Hannah-Kaliada/Rattysitter/README.md

# Дипломный проект 🐭 

dancing rat  

# TODO
- технология vox
## Содержание

- [Аппаратная часть](./hardware/)  
- [Программная часть](./software/)  
- [Документация](./docs/)  
- [Даташиты](./datasheets/)
- [Ссылки](./links/links.md)
- [График](https://docs.google.com/spreadsheets/d/1RWUDlwNgSnQZzl1ud5IH15s1hvJBND-iSX5JjFd0lDk/edit?gid=0#gid=0)  

## 🐀 Мои бусечки 

- Сара — **שרה**  

- Хава — **חוה**  
- Милка — **מלכה**  
- Соня — **סוניה**  
- Ада — **עדה**
