Hannah-Kaliada/Rattysitter/literature/links.txt

https://www.espressif.com/en/solutions/low-power-solutions/esp-now
https://randomnerdtutorials.com/esp-now-esp32-arduino-ide/
