Hannah-Kaliada/Rattysitter/links/links.md

## 🔗 Список

- [ESP32-CAM AI-Thinker Pinout Guide (Random Nerd Tutorials)](https://randomnerdtutorials.com/esp32-cam-ai-thinker-pinout/)
