Hannah-Kaliada/Rattysitter/docs/Ведомость_2025.pdf

Изм. Лист | | № докум. | Подп. | Дата
Разраб. | Коледа | | | Устройство мониторинга комнаты ребенка. Ведомость документов | Лит. | Лист | Листов
Пров. | Стракович | | | | | Т | | 66 | 66
Т. контр. | | | | | ЭВМ, гр. 250503
Н. контр.
Утв.

## БГУИР КП 1–40 02 01 312 Д1

Обозначение | Наименование | Примечание
| Графические документы
ГУИР.400201.312 ПД ГУИР.400201.312 ПД | Устройство мониторинга комнаты ребенка. Устройство мониторинга комнаты ребенка.
| Схема программы Схема программы | Формат А3
ГУИР.400201.312 Э1 | Устройство мониторинга комнаты ребенка.
| Схема электрическая структурная | Формат А4
ГУИР.400201.312 Э2 ГУИР.400201.312 Э2 | Устройство мониторинга комнаты ребенка. Устройство мониторинга комнаты ребенка.
| Схема электрическая функциональная Схема электрическая функциональная | Формат А3 Формат А3
ГУИР.400201.312 Э3 ГУИР.400201.312 Э3 | Устройство мониторинга комнаты ребенка. Устройство мониторинга комнаты ребенка.
| Схема электрическая принципиальная Схема электрическая принципиальная | Формат А3 Формат А3
ГУИР.400201.312 МЭ ГУИР.400201.312 МЭ | Устройство мониторинга комнаты ребенка. Устройство мониторинга комнаты ребенка.
| Схема платы Схема платы | Формат А4 Формат А4
ГУИР.400201.312 ВО ГУИР.400201.312 ВО | Устройство мониторинга комнаты ребенка. Устройство мониторинга комнаты ребенка.
| Схема модели корпуса Схема модели корпуса | Формат А4 Формат А4
| Текстовые документы
БГУИР КП БГУИР КП 1–40 02 01 312 40 02 01 312 ПЗ | Пояснительная записка Пояснительная записка | 66 с.
ГУИР.400201.312 ПЭ3 | Устройство мониторинга комнаты ребенка.
| Перечень элементов | 1 л., в ПЗ

Изм. Лист | № докум. | Подп. | Дата

## БГУИР КП 1–40 02 01 YYY Д1

Лист
2
Обозначение | Наименование | Примечание
