Hannah-Kaliada/Rattysitter/docs/модель корпуса.pdf

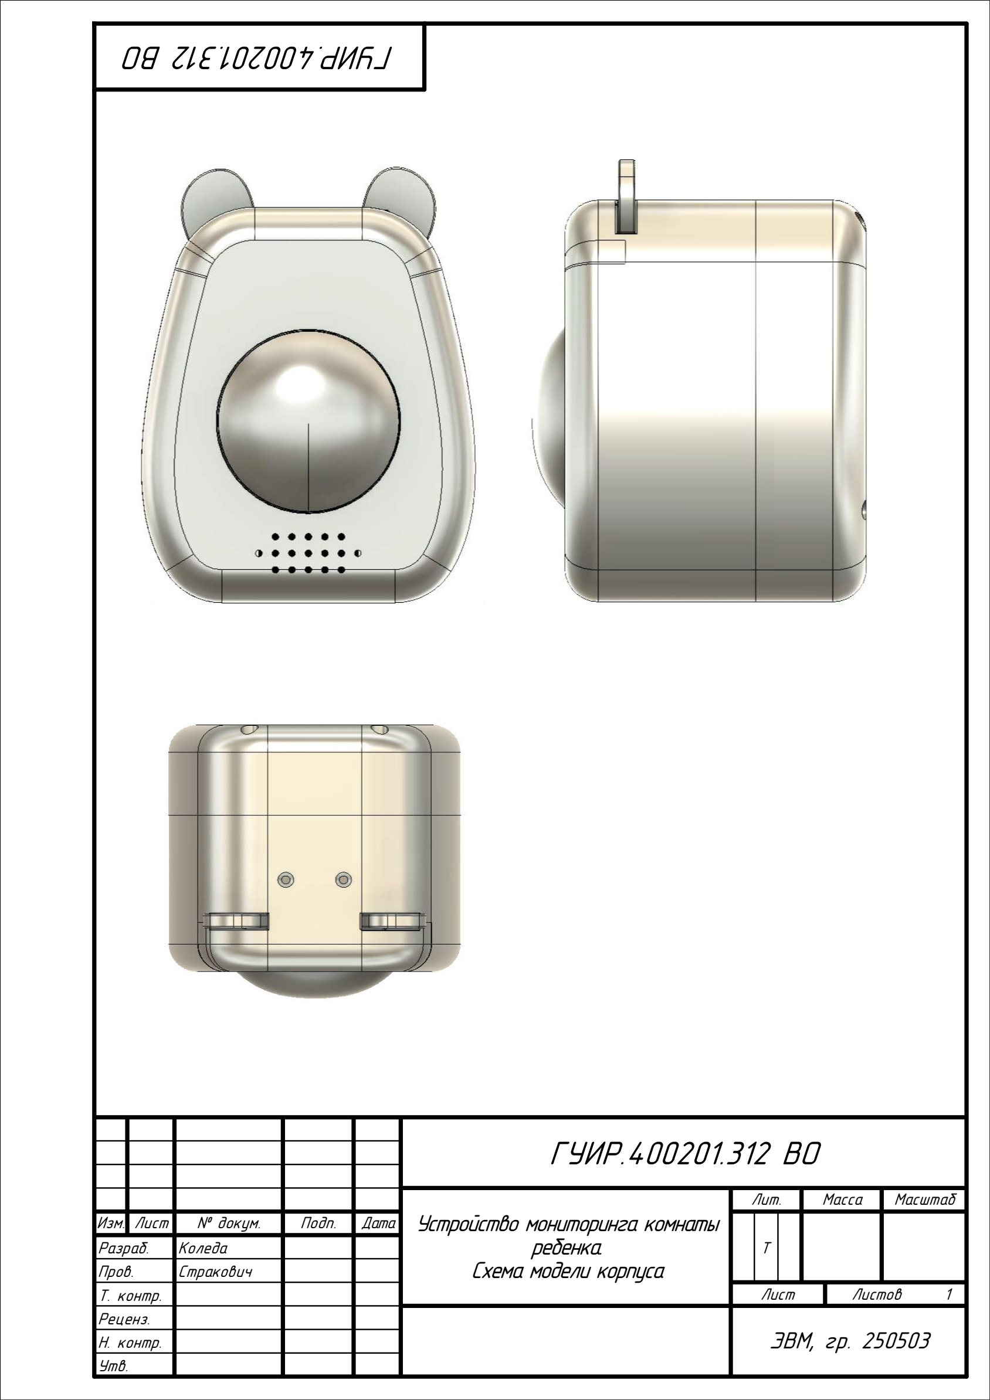
[picture p1: page 1]

| | | | ГУИР.400201.312 ВО
| | | | Устройство мониторинга комнаты ребенка. Схема модели корпуса | Лит. | Масса | Масштаб
Изм. Лист | № докум. | Подп. | Дата | | | Т
Разраб. | Коледа
Пров. | Стракович
Т. контр. | | | | Лист | Листов
Реценз. | | | | ЭВМ, гр. 250503
Н. контр.
Утв.

Изм. Лист | | № докум. | Подп. | Дата
Разраб. | Фамилия | | | Название. Тип чертежа | Лит. | Лист | Листов
Пров. | Фамилия | | | | | Т | | 2
Т. контр. | | | | | ЭВМ, гр. XXXXXX
Н. контр.
Утв.

# ГУИР.400201.YYY ZZ

Изм. Лист | № докум. | Подп. | Дата

# ГУИР.400201.YYY ZZ

Лист
