Hannah-Kaliada/Rattysitter/docs/перечень 2025.pdf

Изм. Лист | | № докум. | Подп. | Дата
Разраб. | Коледа | | | Устройство мониторинга комнаты ребенка. Перечень элементов | Лит. | Лист | Листов
Пров. | Стракович | | | | | Т | | 1 | 1
Т. контр. | | | | | ЭВМ, гр. 250503
Н. контр.
Утв.

## ГУИР.400201.312 ПЭ3

Поз. обозна-чение | Наименование | Кол. | Примечание
| Микросхемы
DD1 | AHT10 / DIP-4, датчик температуры, влажности , датчик температуры, влажности | 1
DD2 | ESP32-WROOM-32 / DIP-34, микроконтроллер | 1
DD3 | INMP-441 / DIP-6, микрофон | 1
DD4 | HW-084 / DIP-10, часы реального времени | 1
DD5 | BH1750/ DIP-5, датчик уровня освещенности | 1

Зона

HG1 HG1 | OLED-0.96-4IIC-Y, OLED-дисплей 128x64 OLED-0.96-4IIC-Y, OLED-дисплей 128x64
| пикселей пикселей | 1 1
HL1..HL5 GNL-8003RGB-C-TL, Светодиод многоцветный 25° HL1..HL5 GNL-8003RGB-C-TL, Светодиод многоцветный 25°
| d=8мм 30мА, с общим катодом d=8мм 30мА, с общим катодом | 5 5
| Резисторы
R1..R15 | CF1/4W-470R резистор выводной, 470 Ом
| 0.25 Вт, ±5% | 15
| Разъемы
XS1 | TYPE-C-2Pin-M, гнездо, 2 контакта, прямой | 1

Изм. Лист | № докум. | Подп. | Дата

## ГУИР.400201.YYY ПЭ3

Поз. обозна-чение | Наименование | Кол. | Примечание
| Резисторы
R1, R2 R1, R2 | С2-29В-0,5Вт резистор выводной, 10 кОм С2-29В-0,5Вт резистор выводной, 10 кОм
| 0.5 Вт, ±0.25% 0.5 Вт, ±0.25% | 2 2
R3 | Резистор выводной 240 Ом, 0.5 Вт, ±5% | 1
R4...R9 R4...R9 | RC1206FR-074K7L резистор SMD 1206 RC1206FR-074K7L резистор SMD 1206
| 4.7 кОм, 0.25 Вт, ±1% 4.7 кОм, 0.25 Вт, ±1% | 6 6

Зона

Лист
2
| Диоды

VD1...VD4 1N4005, диод выпрямительный, 1 А, 600 В, VD1...VD4 1N4005, диод выпрямительный, 1 А, 600 В,

| DO-41 DO-41 | 4 4
VD5, VD6 VD5, VD6 1N5818, 1N5818, диод Шоттки, 30 В, 1 А, диод Шоттки, 30 В, 1 А, DO-41 | | 2
| Разъемы

XP1, XP2 PLS-4 (DS-1021-1x4), вилка штыревая XP1, XP2 PLS-4 (DS-1021-1x4), вилка штыревая

| шаг 2.54мм, 4 контакта, прямая шаг 2.54мм, 4 контакта, прямая | 2 2
| Устройства коммутации
SA1 | EG1213, EG1213, переключатель движковый, переключатель движковый, ВКЛ-ВКЛ | 1
SA2 | MTS-102 A-2, тумблер ВКЛ тумблер ВКЛ-ВКЛ | 1
SW1...SW3 KAN1211 KAN1211-1201B, кнопка тактовая кнопка тактовая 12x12x12 mm 12x12x12 mm | | 3
| Транзисторы
VT1 | IRF520NPBF, IRF520NPBF, N-канал, 100 В, 9.7 А канал, 100 В, 9.7 А | 1
