Hannah-Kaliada/Rattysitter/docs/схема платы.pdf

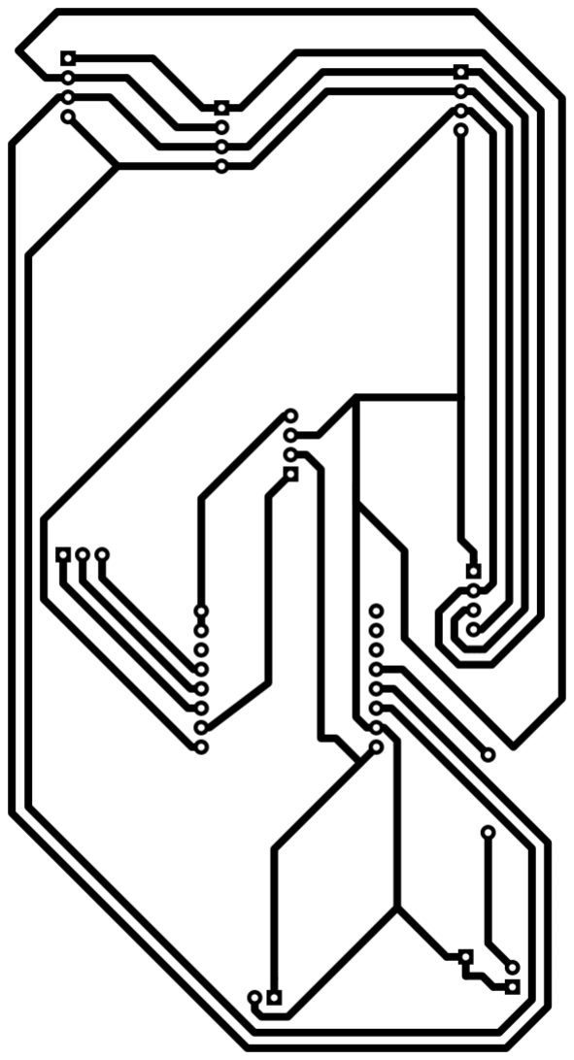
[picture p9: figure]

| | | | | ГУИР.400201.311 МЭ1
| | | | | Схема платы. Схема электромонтажная | Лит. | Масса | Масштаб
Изм.Лист | | № докум. | Подп. | Дата | | | У
Разраб. | | Коледа
Пров. | | Селезнев
Лист | Листов 1
| | | | | ЭВМ, гр. 250503
