Hannah-Kaliada/Rattysitter/docs/PCB_PCB_bear_2025-05-05-2.png

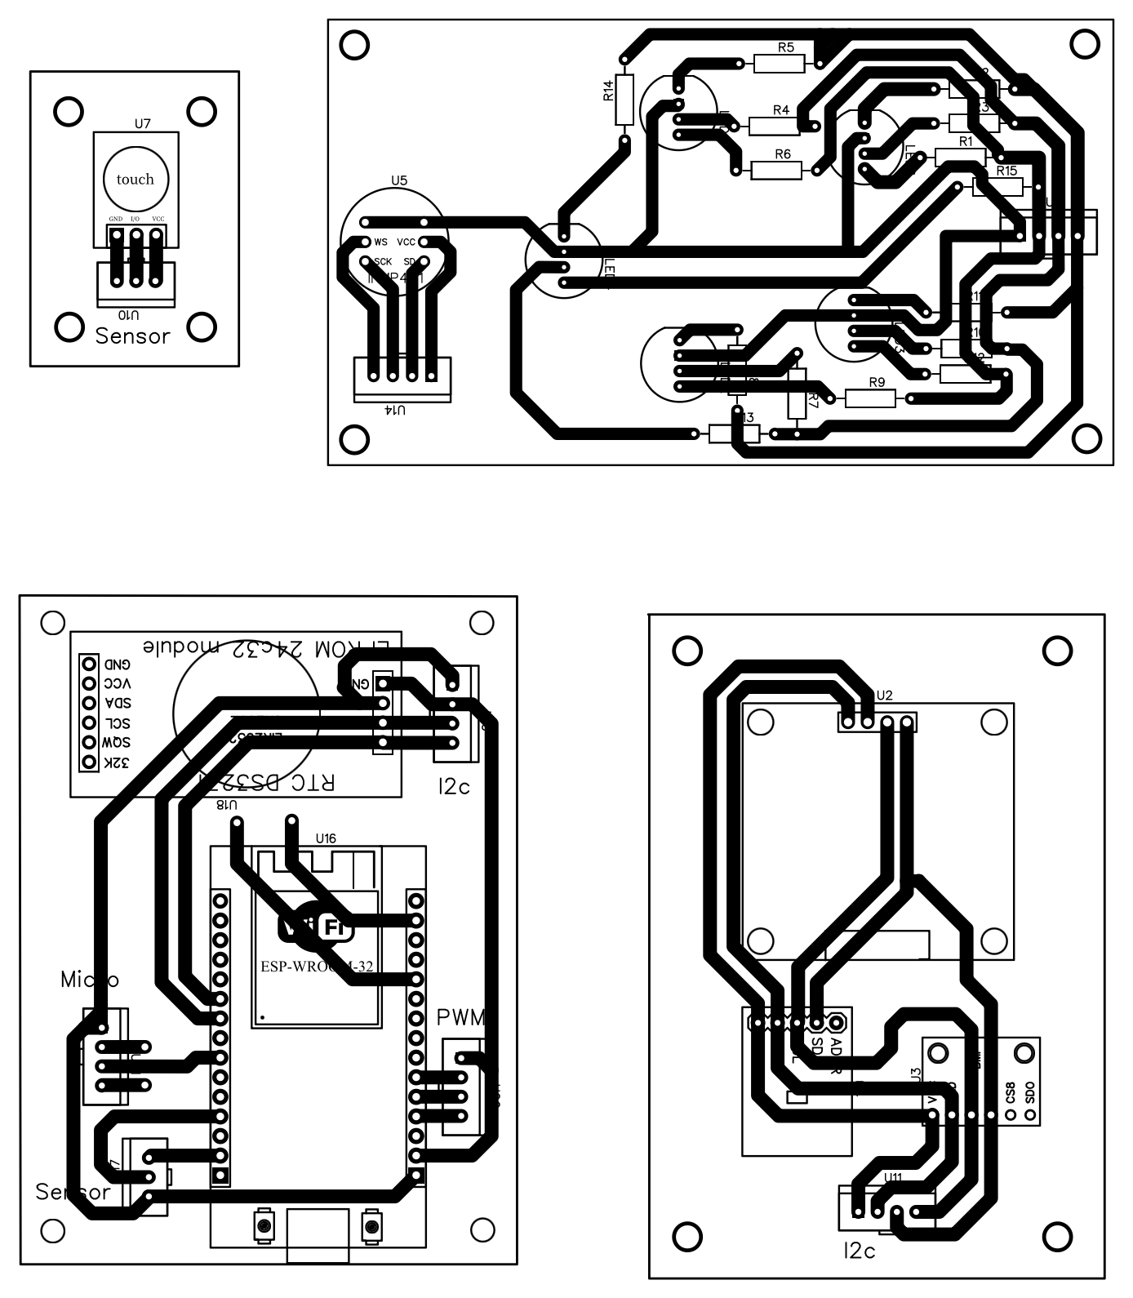
docs/PCB_PCB_bear_2025-05-05-2.png
