Hannah-Kaliada/Rattysitter/docs/Принципиальная схема.pdf

A

B

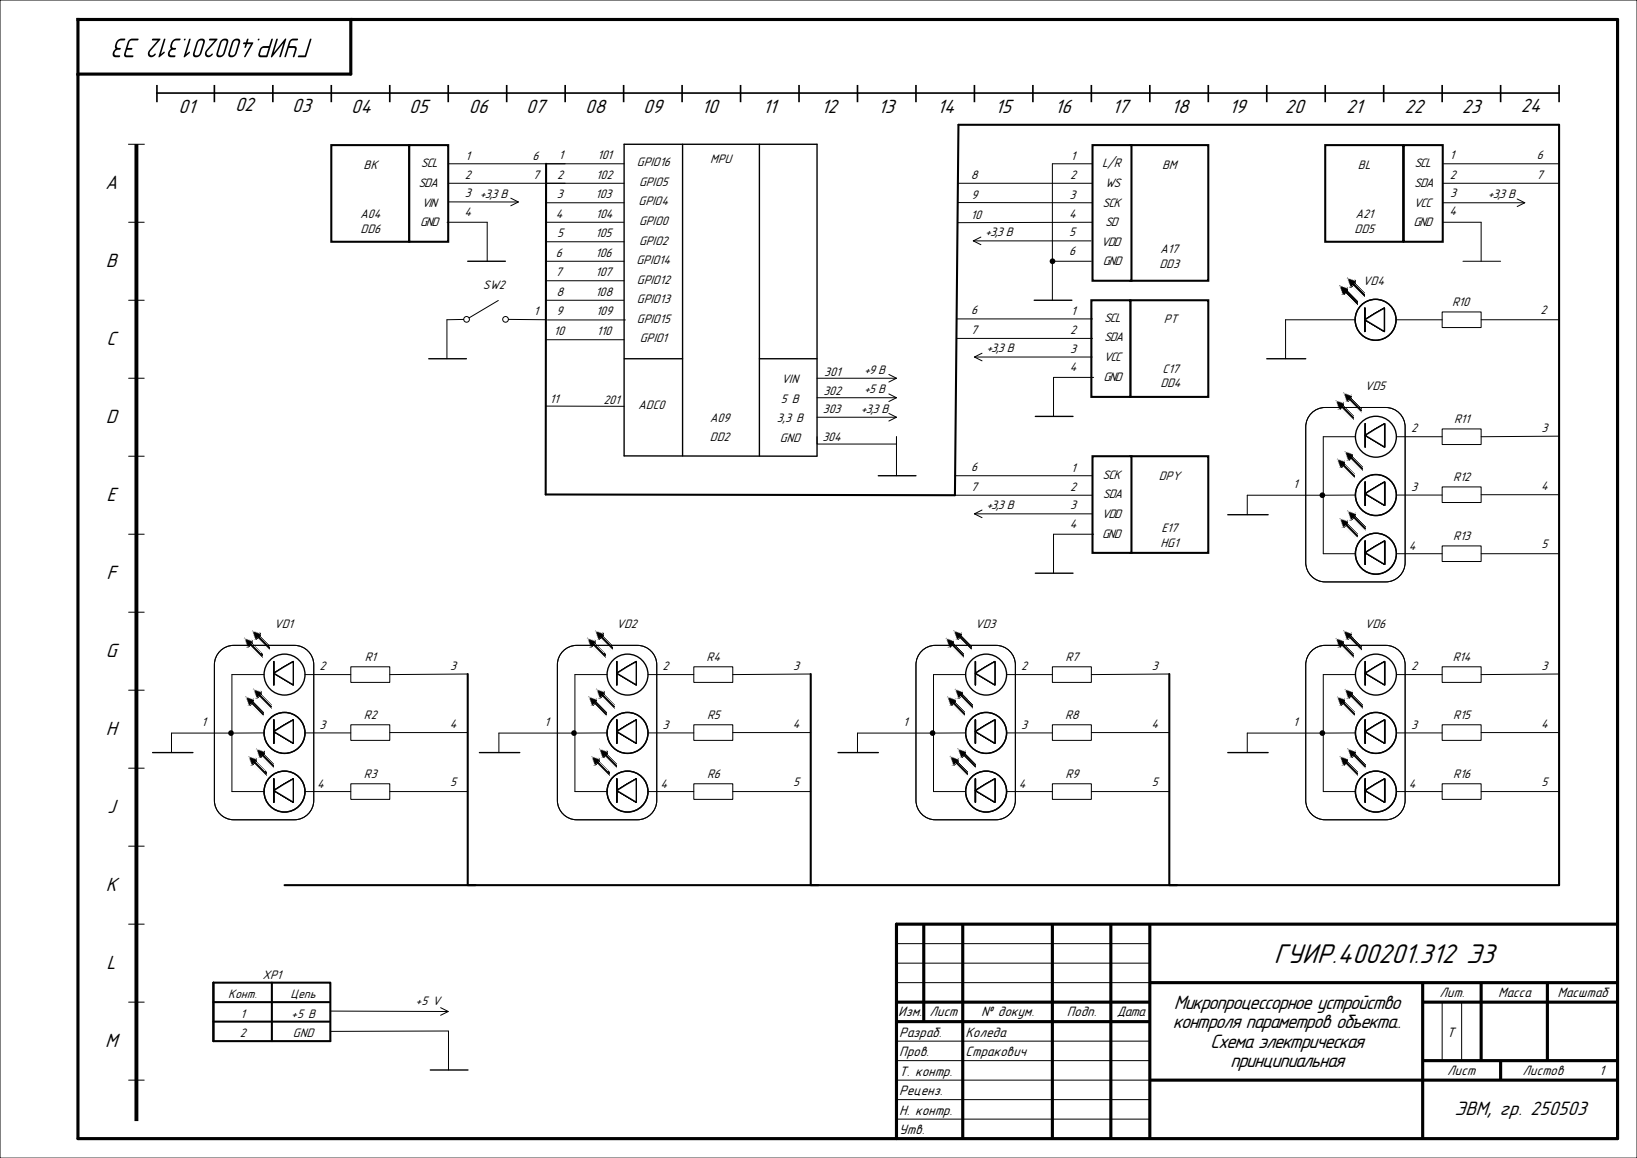
[picture p11: page 1]

GPIO16 GPIO5 GPIO4 GPIO0 GPIO2 GPIO14 GPIO12 GPIO13 GPIO15 GPIO1 | MPU A09 DD2

ADC0 | | VIN 5 В 3,3 В GND | 4

ГУИР.400201.312 Э3

Микропроцессорное устройство контроля параметров объекта.. Схема электрическая принципиальная | Лит. | Масса | Масштаб

Пров. | Стракович
Т. контр. | | Лист | Листов 1
Реценз. | | ЭВМ, гр. 250503
Н. контр.
Утв.
