Hannah-Kaliada/Rattysitter/docs/функциональная 2025.pdf

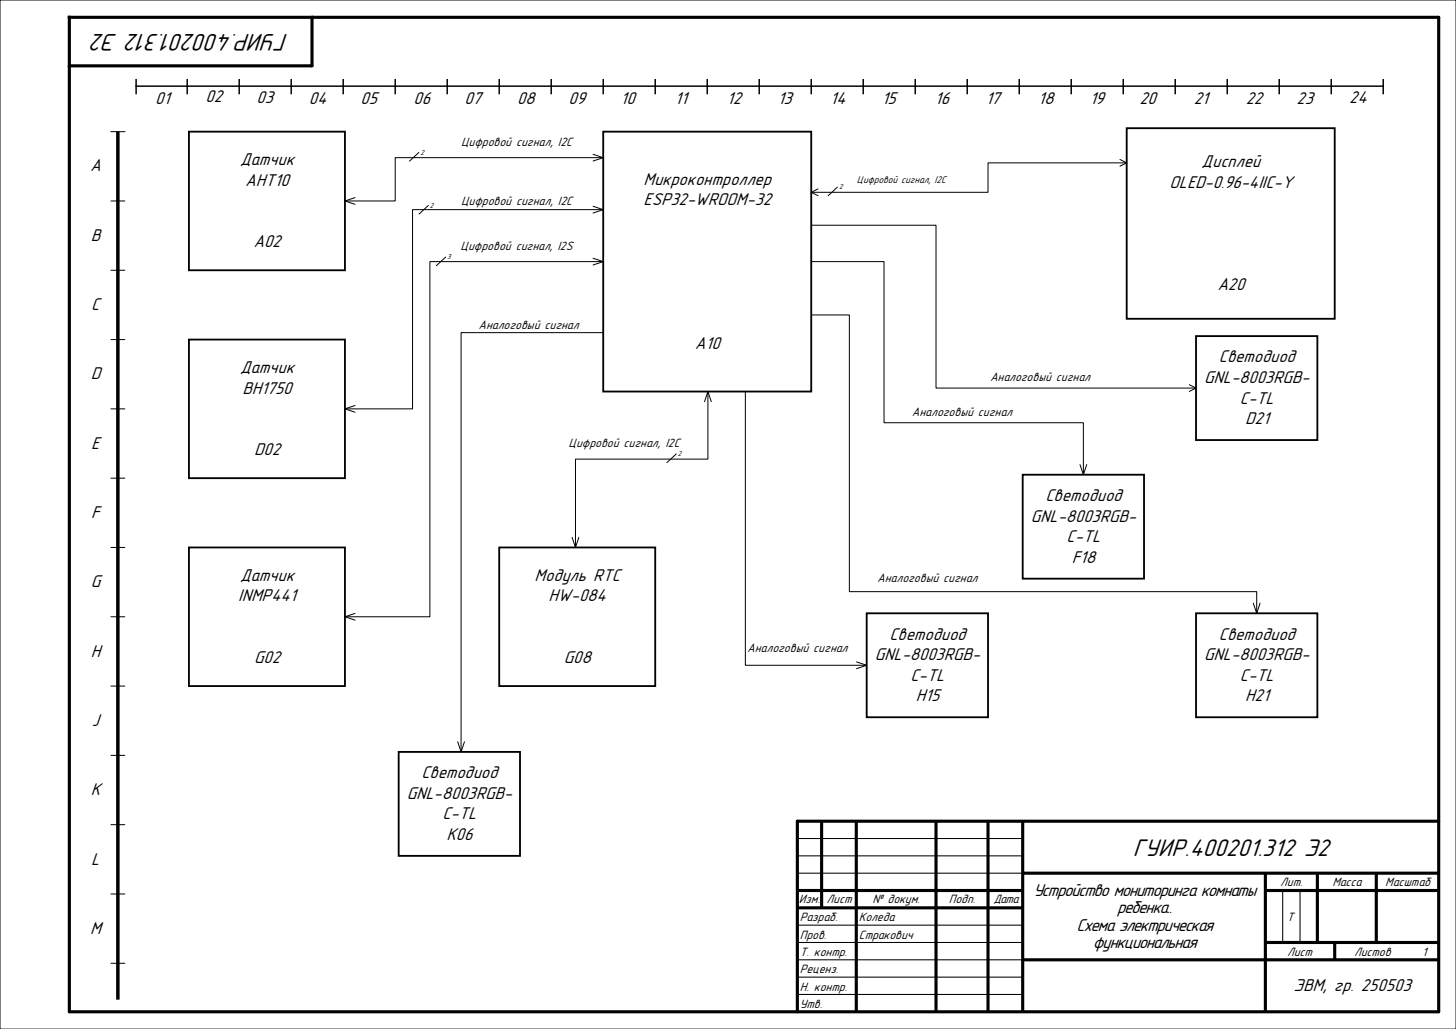
[picture p12: page 1]
Микроконтроллер ESP32-WROOM-32; Дисплей OLED-0.96-4IIC-Y; Светодиод GNL-8003RGB- C-TL D21; Датчик AHT10; Датчик BH1750; Датчик INMP441; Цифровой сигнал, I2C; Аналоговый сигнал; Цифровой сигнал, I2S; Модуль RTC HW-084; Светодиод GNL-8003RGB- C-TL F18; Светодиод GNL-8003RGB- C-TL H21; Светодиод GNL-8003RGB- C-TL H15; Светодиод GNL-8003RGB- C-TL K06

ГУИР.400201.312 Э2

Устройство мониторинга комнаты ребенка.. Схема электрическая функциональная | Лит. | Масса | Масштаб

Изм. Лист | № докум. | Подп. | Дата | | | Т
Разраб. | Коледа
Пров. | Стракович
Т. контр. | | | | Лист | Листов 1
Реценз. | | | | ЭВМ, гр. 250503
Н. контр.
Утв.
