Hannah-Kaliada/Rattysitter/docs/принципиальная 2025.pdf

A

B

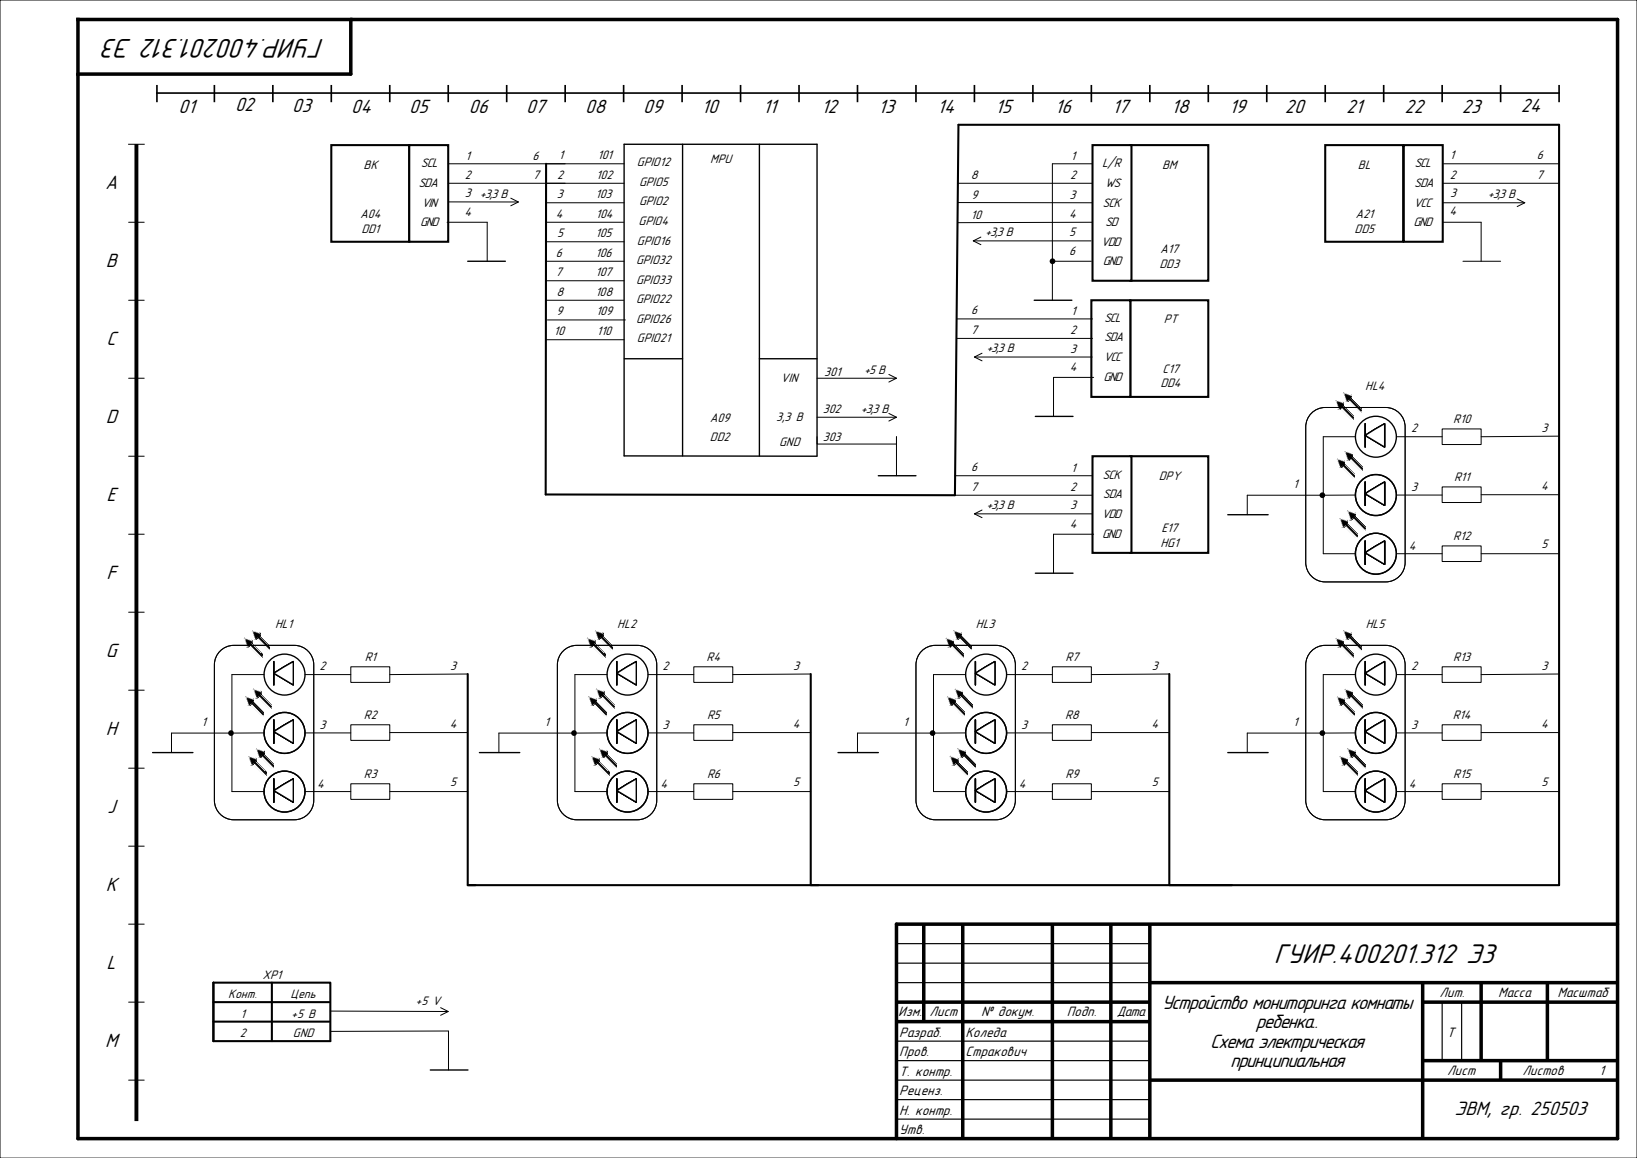
[picture p13: page 1]

ГУИР.400201.312 Э3

Устройство мониторинга комнаты ребенка.. Схема электрическая принципиальная | Лит. | Масса | Масштаб

Пров. | Стракович
Т. контр. | | Лист | Листов 1
Реценз. | | ЭВМ, гр. 250503
Н. контр.
Утв.
