Hannah-Kaliada/Rattysitter/docs/Принципиальная схема-Bebrachka.pdf

A

B

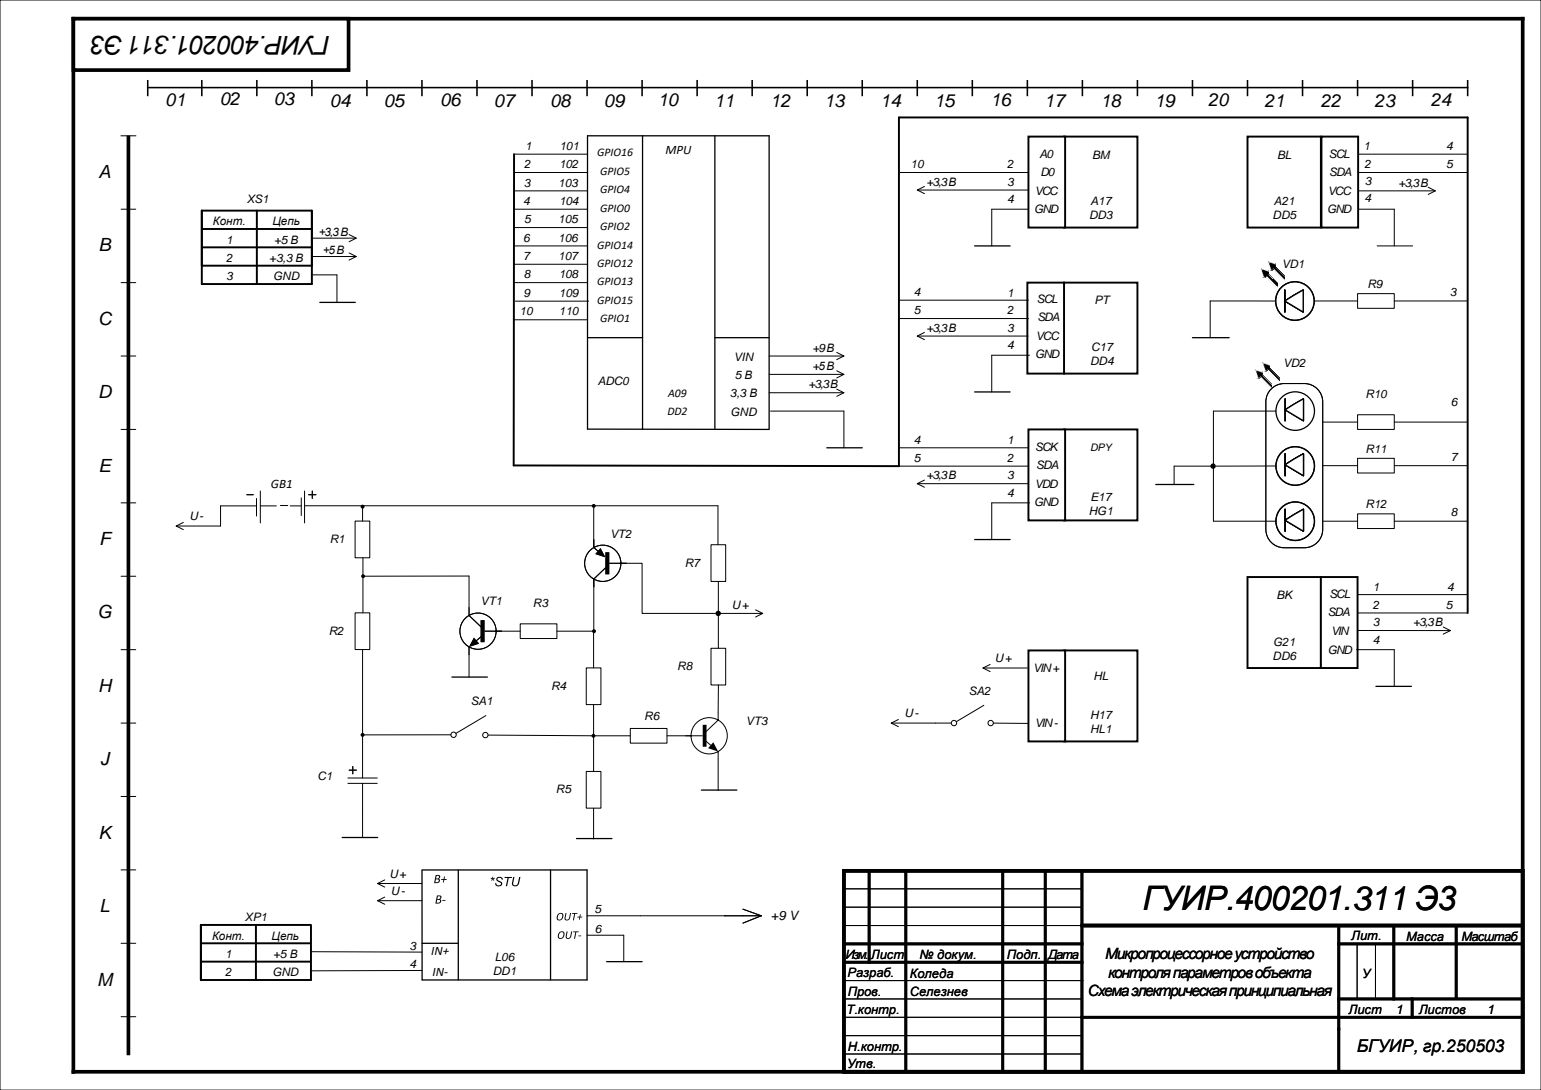
[picture p14: page 1]
