Hannah-Kaliada/Rattysitter/docs/структурка.pdf

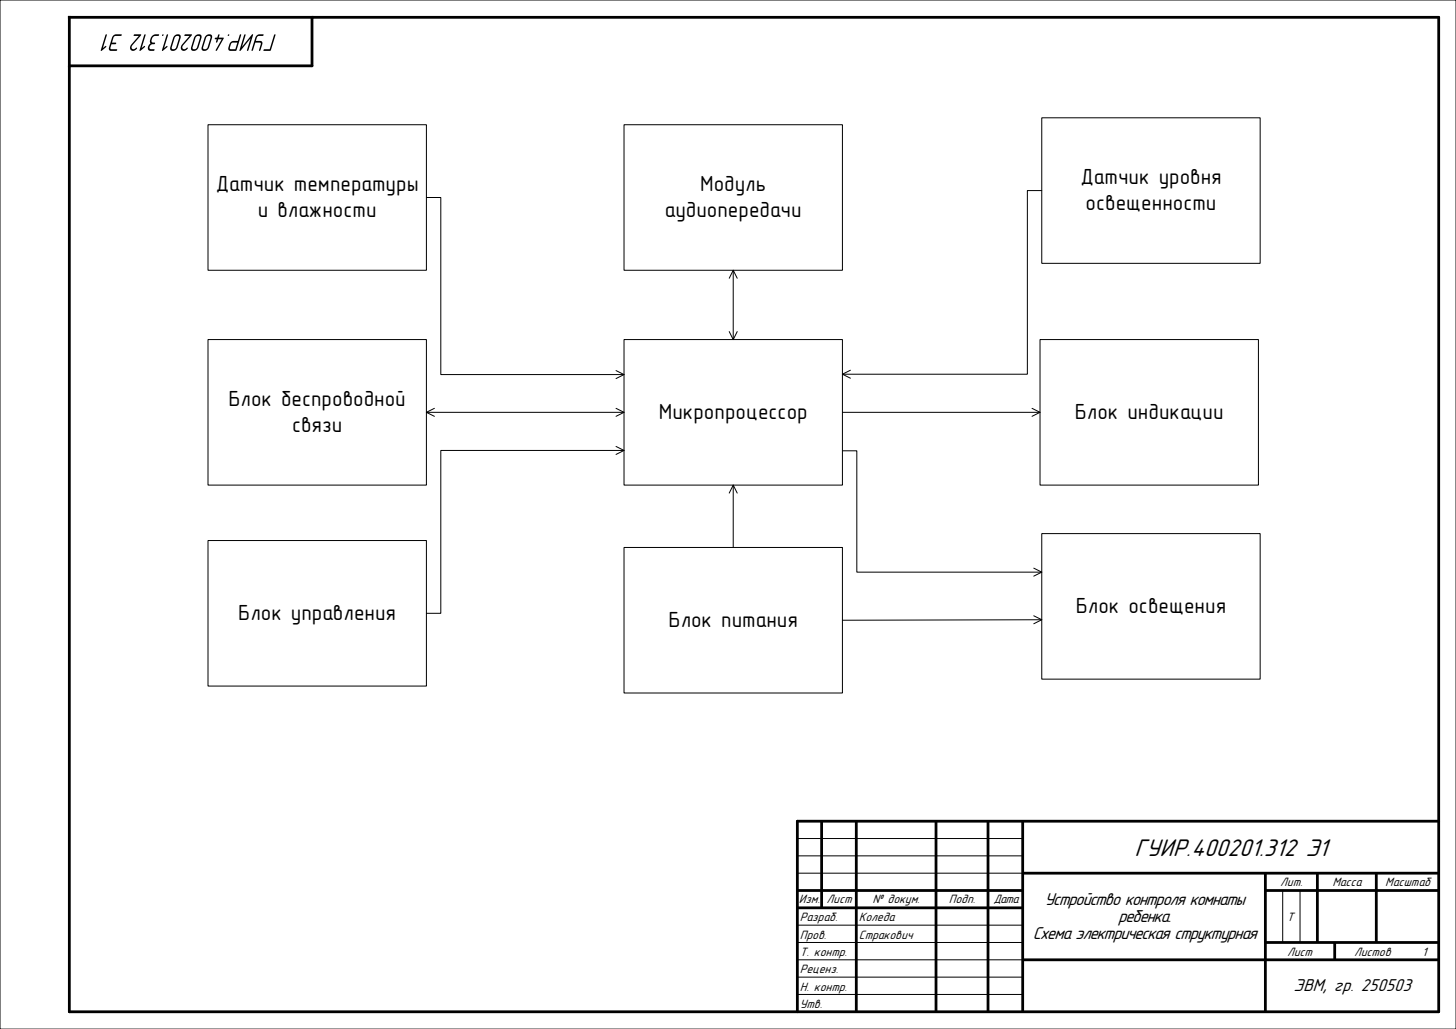
[picture p15: page 1]
Микропроцессор; Датчик температуры и влажности; Датчик уровня освещенности; Модуль аудиопередачи; Блок беспроводной; связи; Блок индикации; Блок управления; Блок освещения Блок питания

ГУИР.400201.312 Э1

Устройство контроля комнаты ребенка. Схема электрическая структурная | Лит. | Масса | Масштаб

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
