Hannah-Kaliada/Rattysitter/docs/структурная схема.pdf

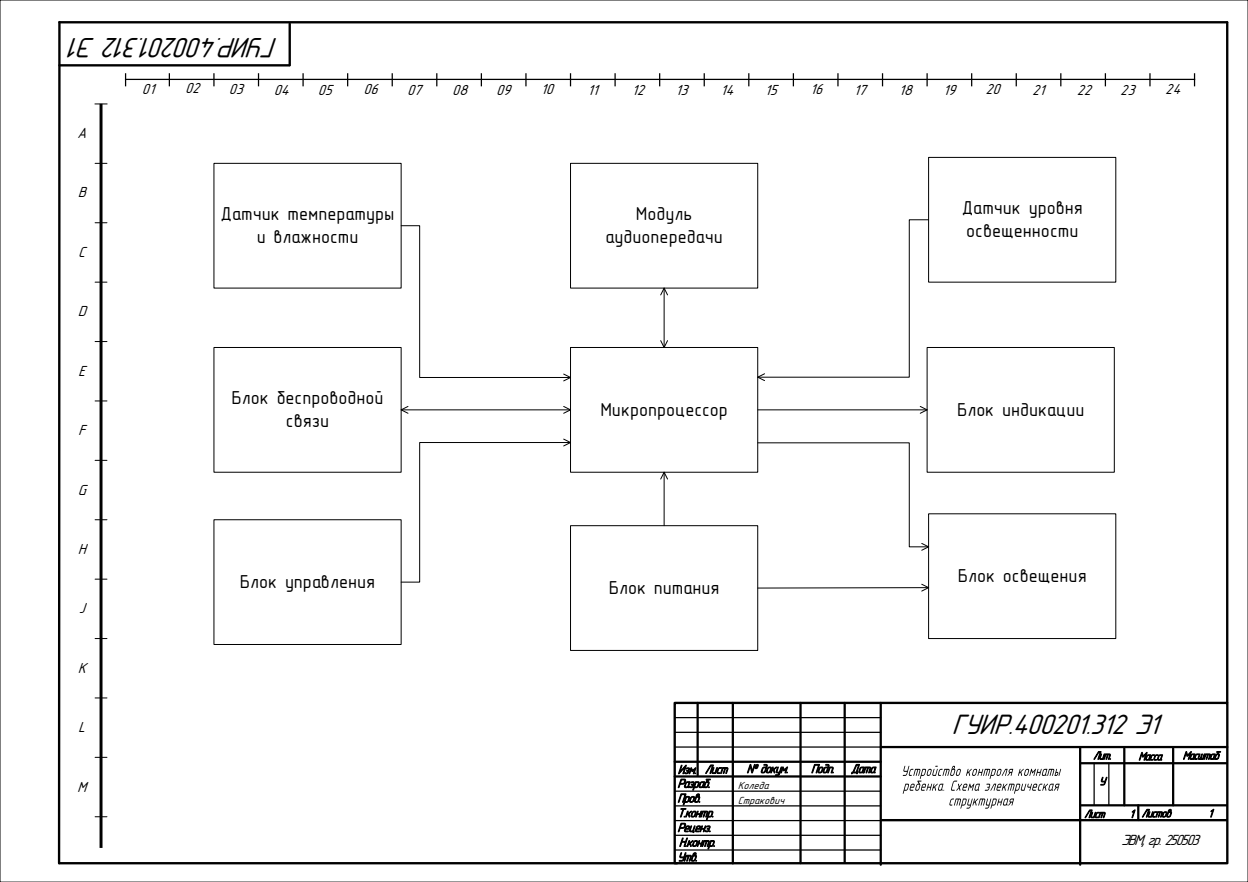
[picture p16: page 1]
Изм. Лист Разраб. Пров. Т.контр.; Н.контр.; № докум.; Подп.; Дата; ГУИР.400201.312 Э1; Лит.; Масса; Масштаб; Лист; Листов; Утв.; Реценз.; Коледа; Стракович; ЭВМ, гр. 250503; Микропроцессор; Датчик температуры и влажности; Датчик уровня освещенности; Модуль аудиопередачи; Блок беспроводной; связи; Блок индикации; Блок управления; Блок освещения Блок питания
