Hannah-Kaliada/Rattysitter/docs/структурная_А4_2025.pdf

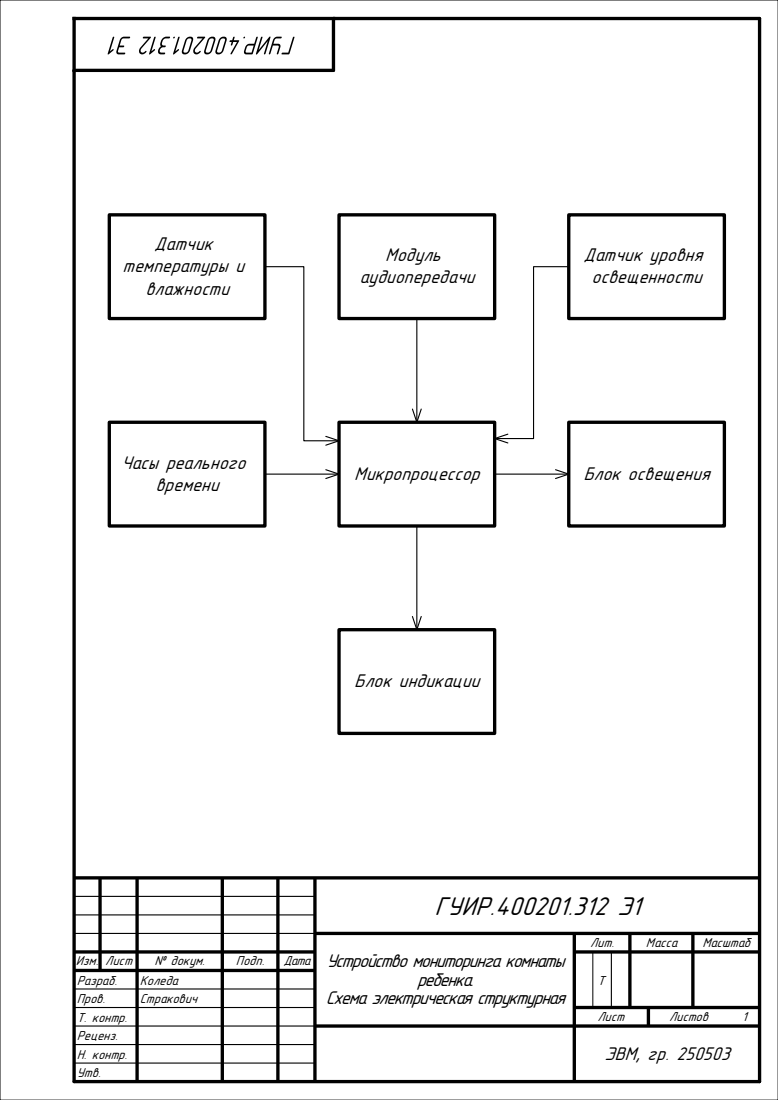
[picture p17: page 1]
Датчик уровня освещенности; Блок освещения; Модуль аудиопередачи; Датчик температуры и влажности; Микропроцессор; Часы реального времени; Блок индикации

ГУИР.400201.312 Э1

Устройство мониторинга комнаты ребенка. Схема электрическая структурная | Лит. | Масса | Масштаб

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
