Hannah-Kaliada/Rattysitter/docs/схема программа.pdf

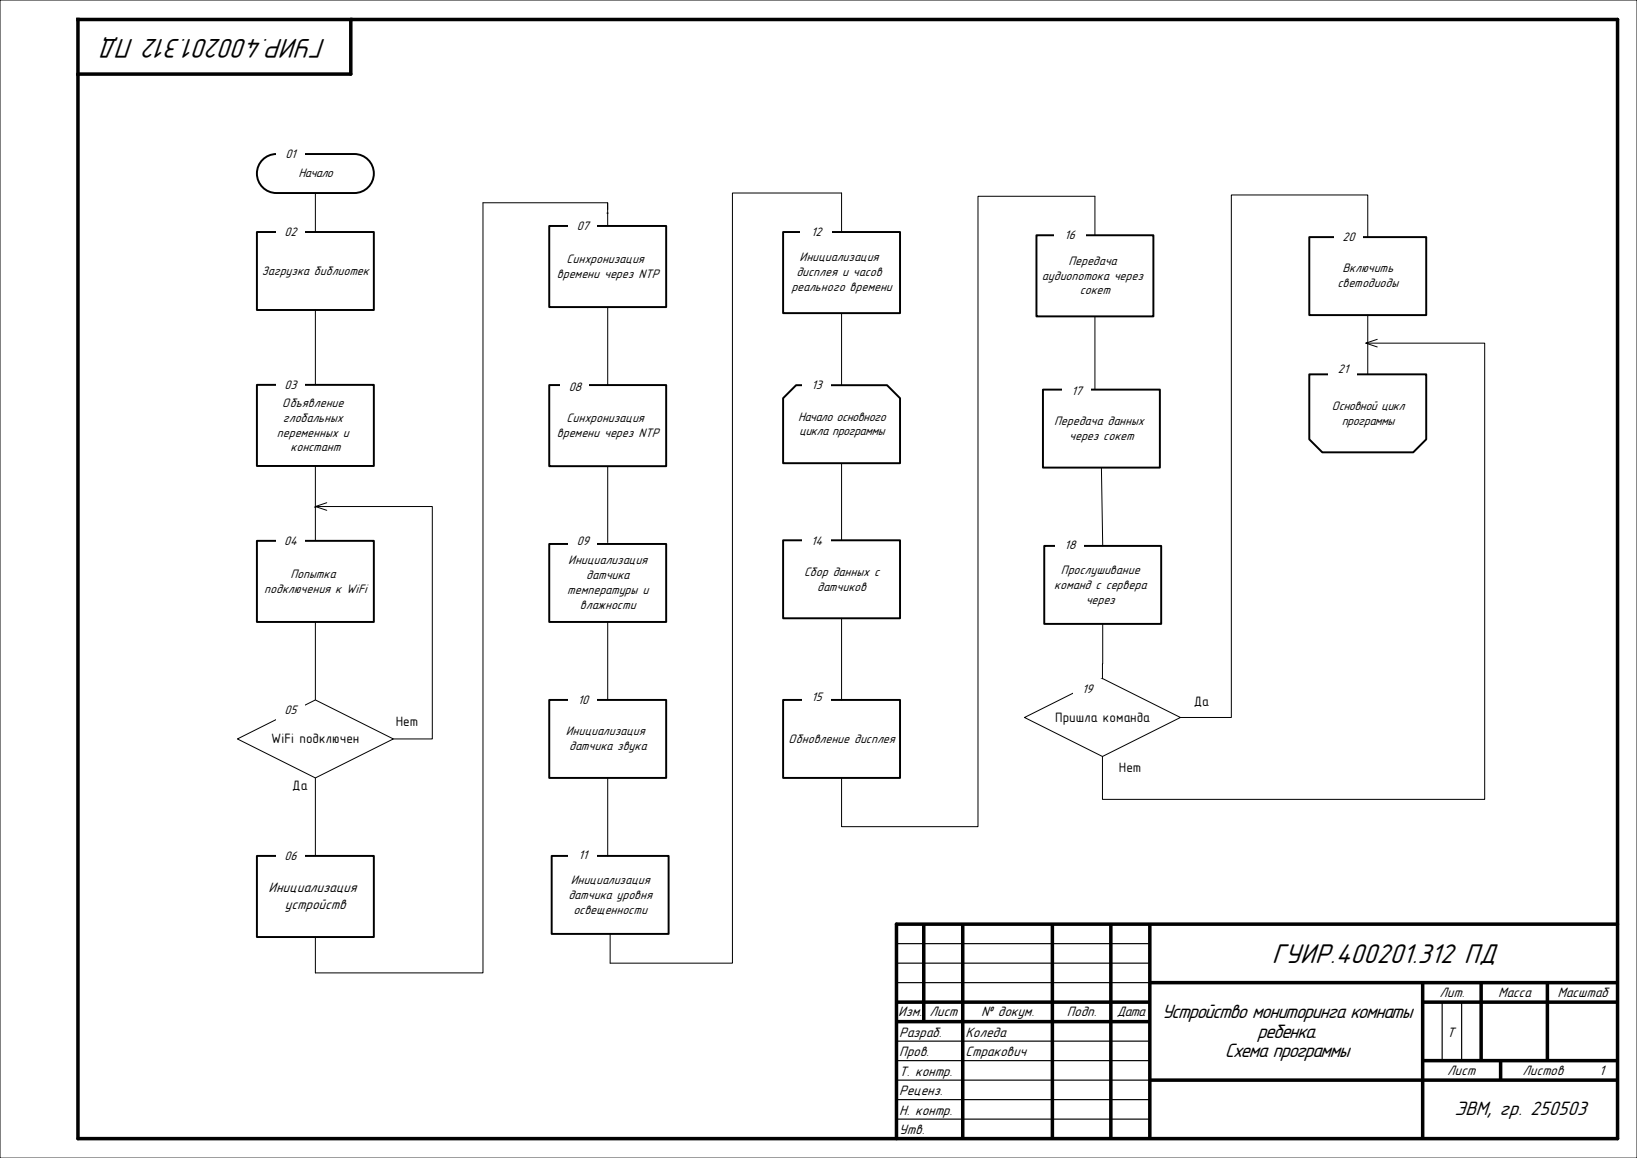
[picture p18: page 1]
Начало; Загрузка библиотек; Объявление глобальных переменных и констант; Попытка подключения к WiFi; WiFi подключен; Нет; Инициализация устройств; Инициализация датчика уровня освещенности; Инициализация датчика звука; Инициализация датчика температуры и влажности; Инициализация дисплея и часов реального времени; Начало основного цикла программы; Сбор данных с датчиков; Обновление дисплея; 12 Передача аудиопотока через сокет; Прослушивание команд с сервера через; Передача данных через сокет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

Синхронизация
времени через NTP

ГУИР.400201.312 ПД

Устройство мониторинга комнаты ребенка. Схема программы | Лит. | Масса | Масштаб

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
