Hannah-Kaliada/Rattysitter/(commit log)

2025-10-15 Add ESP32-CAM pinout guide link to links.md
2025-10-15 Fix link formatting for the 'График' section
2025-10-15 Добвлен курсач прошлого (6) сема
2025-10-26 Add MAC addresses for esp8266 and esp32-cam
